VictorGMoreira/LineFollowerRobot/LineFollowerRobot/Core/Src/main.c

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
/* Includes ------------------------------------------------------------------*/
#include "main.h"
#include "adc.h"
#include "dma.h"
#include "tim.h"
#include "gpio.h"

/* USER CODE BEGIN Includes */
#include "control.h"
#include "comm.h"
/* USER CODE END Includes */


/* USER CODE BEGIN PV */

volatile uint16_t line_sensor_raw[SENSOR_COUNT];
PID_t pid;

volatile bool tick_flag = false;

/* Largada: 0 = liga PARADO e so anda com o comando RUN (seguro para calibrar).
 * Para competicao sem o ESP, coloque o atraso em ms (ex.: 3000 = anda 3 s apos ligar). */
#define AUTO_START_DELAY_MS   0

/* quantos ticks seguidos sem ver linha até considerar "perdida de fato"
 * (10 ticks a 500Hz = 20ms — ajuste se achar sensível demais ou de menos) */
#define LOST_DEBOUNCE_TICKS   10

/* quanto tempo girando tentando recuperar até desistir e parar por
 * segurança (1000 ticks a 500Hz = 2 segundos) */
#define LOST_TIMEOUT_TICKS    1000

static uint32_t     lost_ticks = 0;             /* ticks seguidos sem ver linha */
static RobotState_t prev_state = STATE_INIT;    /* estado no tick anterior */

/* RobotState_t agora fica em control.h (comm.c tambem usa) */
volatile RobotState_t robot_state = STATE_INIT;

/* USER CODE END PV */

void SystemClock_Config(void);
/* USER CODE BEGIN 0 */

static void Sensors_StartADC(void)
{
    HAL_ADC_Start_DMA(&hadc1, (uint32_t*)line_sensor_raw, SENSOR_COUNT);
    /* O DMA circular atualiza line_sensor_raw sozinho; as interrupcoes de meia/fim de
     * transferencia so ocupariam a CPU (a cada poucos us) e travariam o loop e a UART. */
    __HAL_DMA_DISABLE_IT(hadc1.DMA_Handle, DMA_IT_HT | DMA_IT_TC);
    HAL_NVIC_DisableIRQ(DMA2_Stream0_IRQn);
}

/* Se o ADC der overrun, o DMA para e os sensores congelam: reinicia. */
static void Sensors_CheckADC(void)
{
    if (__HAL_ADC_GET_FLAG(&hadc1, ADC_FLAG_OVR)) {
        HAL_ADC_Stop_DMA(&hadc1);
        __HAL_ADC_CLEAR_FLAG(&hadc1, ADC_FLAG_OVR);
        Sensors_StartADC();
        Comm_SendLine("EVT ADC RESTART");
    }
}

static bool Robot_IsMoving(RobotState_t s)
{
    return s == STATE_SEGUINDO_LINHA || s == STATE_LINHA_PERDIDA || s == STATE_TESTE_MOTOR;
}

/* USER CODE END 0 */

/**
  * @brief  The application entry point.
  * @retval int
  */
int main(void)
{
  /* MCU Configuration--------------------------------------------------------*/

  /* Reset of all peripherals, Initializes the Flash interface and the Systick. */
  HAL_Init();

  /* Configure the system clock */
  SystemClock_Config();

  /* Initialize all configured peripherals */
  MX_GPIO_Init();
  MX_DMA_Init();
  MX_ADC1_Init();
  MX_TIM2_Init();
  MX_TIM3_Init();
  MX_TIM4_Init();

  /* USER CODE BEGIN 2 */

  Sensors_StartADC();
  Control_Init(&pid, 0.1f, 0.0f, 0.05f, 1000.0f);
  Comm_Init();
  HAL_TIM_Base_Start_IT(&htim4);

  /* USER CODE END 2 */

  /* Infinite loop */
  /* USER CODE BEGIN WHILE */

  while (1)
  {
      Comm_Process();
      Sensors_CheckADC();

      if (tick_flag) {
          tick_flag = false;

          /* Watchdog do link (comando WD): sem nada do ESP por muito tempo -> para */
          if (Robot_IsMoving(robot_state) && Comm_LinkTimedOut()) {
              Motors_Stop();
              motor_test_ticks = 0;
              robot_state = STATE_PARADO;
              Comm_SendLine("EVT WD STOP");
          }

          /* Entrou em seguir linha vindo de outro estado (RUN, largada): zera o contador */
          if (robot_state == STATE_SEGUINDO_LINHA &&
              prev_state != STATE_SEGUINDO_LINHA && prev_state != STATE_LINHA_PERDIDA) {
              lost_ticks = 0;
          }

          switch (robot_state) {

              case STATE_INIT:
                  Motors_Stop();
#if AUTO_START_DELAY_MS > 0
                  if (HAL_GetTick() >= AUTO_START_DELAY_MS) {
                      PID_Reset(&pid);
                      LineSensor_ResetMemory();
                      robot_state = STATE_SEGUINDO_LINHA;
                  }
#else
                  robot_state = STATE_PARADO;     /* espera o RUN */
#endif
                  break;

              case STATE_SEGUINDO_LINHA: {
                                int32_t position;
                                bool seen = LineSensor_GetPosition(&position);

                                if (seen) {
                                    lost_ticks = 0;
                                } else {
                                    lost_ticks++;
                                    if (lost_ticks >= LOST_DEBOUNCE_TICKS) {
                                        /* debounce estourou: a partir de agora quem cuida
                                         * do movimento é o pivô fixo, não mais o PID */
                                        robot_state = STATE_LINHA_PERDIDA;
                                        break;
                                    }
                                }

                                /* ainda dentro do debounce (ou linha vista de fato):
                                 * continua seguindo normalmente pelo PID */
                                int32_t error = POSITION_CENTER - position;
                                float pid_output = PID_Step(&pid, error);
                                Motors_ApplyPID(pid_output);
                                break;
                            }

                            case STATE_LINHA_PERDIDA: {
                                int32_t position;
                                bool seen = LineSensor_GetPosition(&position);

                                if (seen) {
                                    /* reencontrou -> reseta o PID (não herdar integral do
                                     * tempo girando) e volta a seguir normalmente já neste tick */
                                    lost_ticks = 0;
                                    PID_Reset(&pid);
                                    robot_state = STATE_SEGUINDO_LINHA;

                                    int32_t error = POSITION_CENTER - position;
                                    float pid_output = PID_Step(&pid, error);
                                    Motors_ApplyPID(pid_output);
                                    break;
                                }

                                lost_ticks++;
                                if (lost_ticks >= LOST_TIMEOUT_TICKS) {
                                    /* girou tempo demais sem achar nada: desiste por segurança */
                                    Motors_Stop();
                                    robot_state = STATE_PARADO_SEGURANCA;
                                    Comm_SendLine("EVT LOST STOP");
                                    break;
                                }

                                /* ainda dentro do timeout: pivô fixo na direção do último lado */
                                Motors_PivotRecover();
                                break;
                            }


              case STATE_PARADO:
              case STATE_PARADO_SEGURANCA:
                  Motors_Stop();
                  break;

              case STATE_TESTE_MOTOR:
                  /* os motores ja foram ligados pelo comando MOTOR; aqui so conta o tempo */
                  if (motor_test_ticks > 0) {
                      motor_test_ticks--;
                  }
                  if (motor_test_ticks == 0) {
                      Motors_Stop();
                      robot_state = STATE_PARADO;
                      Comm_SendLine("EVT MOTOR DONE");
                  }
                  break;

              case STATE_CALIBRANDO:
                  Motors_Stop();
                  LineSensor_CalibSample();
                  break;

              default:
                  Motors_Stop();
                  break;
          }

          prev_state = robot_state;
      }

      /* USER CODE END WHILE */

      /* USER CODE BEGIN 3 */
  }
  /* USER CODE END 3 */


}

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
/* USER CODE BEGIN 4 */

void HAL_TIM_PeriodElapsedCallback(TIM_HandleTypeDef *htim)
{
    if (htim->Instance == TIM4) {
        tick_flag = true;
    }
}

/* USER CODE END 4 */
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
