VictorGMoreira/LineFollowerRobot/LineFollowerRobot/LineFollowerRobot.ioc

Mcu.UserName=STM32F401CCUx
PA0-WKUP.Signal=ADCx_IN0
PA1.Signal=ADCx_IN1
PA2.Signal=ADCx_IN2
PA3.Signal=ADCx_IN3
PA4.Signal=ADCx_IN4
PA5.Signal=ADCx_IN5
PA6.Signal=ADCx_IN6
PA7.Signal=ADCx_IN7
PB2.GPIO_Label=MOTOR1_DIR
PB2.Signal=GPIO_Output
PB3.Signal=S_TIM2_CH2
PB4.GPIO_Label=MOTOR2_DIR
PB4.Signal=GPIO_Output
PB5.Signal=S_TIM3_CH2
