VictorGMoreira/LineFollowerRobot/LineFollowerRobot/Core/Inc/main.h

#define MOTOR1_DIR_Pin GPIO_PIN_2
#define MOTOR1_DIR_GPIO_Port GPIOB
#define MOTOR2_DIR_Pin GPIO_PIN_4
#define MOTOR2_DIR_GPIO_Port GPIOB
